jbasila/gree-gmv-esp32/docs/02-bus-discovery.md

# 02 — Bus discovery procedure

## Step 0: squeeze the existing gateway (no hardware needed)

1. Get the gateway IP: it toggles on the LCD every minute, or look at the router's DHCP table.
2. From a laptop on the same LAN:
   ```
   nc <gateway-ip> 10102
   ls2
   line
   ```
   `ls2` should list units like `L6.001 ON 024C 022.7 Low Cool OK - 0` (one line per IDU).
   If that works, add the CoolMasterNet integration in Home Assistant (host = gateway IP,
   port 10102). You now have HA control today, and a scripted way to poke the system while
   sniffing in phase 1.
3. Photograph: gateway sticker (model, S/N), gateway terminal block, and the ODU/IDU terminal
   block it is wired to. Note the terminal labels (G1/G2, D1/D2, H1/H2).

## Step 1: confirm it is CAN with a multimeter (power off nothing)

With the system running, measure each bus wire to the ODU chassis/earth:

| Reading | Meaning |
|---|---|
| both wires ~2.5 V DC, small jitter | CAN (CAN_H / CAN_L idle recessive). Expected. |
| one wire ~0 V, other 12–30 V DC with ripple | power-carrier (H1/H2 style). Different plan. |
| both ~0 V, or ~5 V on one | RS-485-ish or dead line. |

Then measure resistance across the pair with the system **powered off**: ~60 Ω means two
120 Ω terminators, i.e. textbook CAN.

## Step 2: measure the bit rate

Cheapest reliable way: a USB logic analyser (any 24 MHz Saleae clone, ~$10) + PulseView.
Probe CAN_H to GND, set the CAN decoder, read the shortest pulse width. 1/width = bit rate.
Try the ESPHome sniffer below at that rate.

Without a logic analyser: flash `esphome/sniffer.yaml` in listen-only mode and iterate the
`bit_rate` through 20/25/50/100/125 kbps. The correct rate is the one where frames decode and
the TWAI error counters stay at zero. Listen-only never sends ACKs, so a wrong guess cannot
disturb the VRF.

## Hardware shopping list

- ESP32 dev board. Any classic ESP32-WROOM-32 or ESP32-S3; all have TWAI (CAN) built in.
  Classic ESP32 rev < 2 cannot do below 25 kbps; S3/C3/C6 can. Prefer S3 to be safe.
- CAN transceiver breakout, **3.3 V logic**: SN65HVD230 (common, cheap) or TJA1051T/3.
  Do NOT use a 5 V MCP2551/TJA1050 without level shifting.
- Do not add a 120 Ω terminator; the bus is already terminated by Gree.
- Optional: USB logic analyser for PulseView.

## Wiring

```
ESP32 GPIO (tx_pin)  ->  transceiver CTX / D
ESP32 GPIO (rx_pin)  ->  transceiver CRX / R
ESP32 3V3            ->  transceiver VCC
ESP32 GND            ->  transceiver GND
transceiver CANH     ->  G1 (or D1)   (CAN is non-polar per Gree: if nothing decodes, swap)
transceiver CANL     ->  G2 (or D2)
```
Tap the bus in parallel at the same terminals the gateway uses. Keep stubs short.

## Transmit failure diagnosis (2026-10-17)

Symptom: listen-only RX perfect; first transmit → 31 bus errors, error-passive, bus-off, recovery.
Driver reported the frame as sent; the bus never saw it.

Diagnostic firmware `esphome/tx-loop-test.yaml` (raw GPIO: pull CTX low 30 µs, sample CRX):

| Condition | RX low while idle | RX low while TX low |
|---|---|---|
| on the Gree bus | 0–26 / 50 (bus traffic) | 3–9 / 10 (= background only) |
| disconnected from bus | 0 / 50 | 10 / 10 |

→ SN65HVD230 and wiring OK; the Gree bus cannot be pulled dominant by a 3.3 V transceiver
without a shared ground (two signal wires only, ESP32 powered from a laptop). Rs pin = 70 mV (ok),
CTX continuity ok, VCC 3.31 V. DMM on the live bus: CANH ≈ 2.4 V, CANL 0.7–1.4 V relative to
ESP32 GND, i.e. not a 2.5 V-centred bus from our board's point of view.

### Follow-up (2026-10-17 morning)

- Shared ground (ESP32 GND → gateway 12 V negative) changed nothing: loop test still 3–9/10 on-bus.
- Polarity note: when the two bus wires are swapped the receiver goes fully deaf (idle 0/50). Correct
  polarity = whichever gives ~15–35/50 idle on `tx-loop-test.yaml`.
- `tx-hold-test.yaml`: CTX held low for 6 s. RX pin sampled during the hold: 41–100/200 low, i.e. only the
  normal Gree traffic; our dominant never registers, not even at our own receiver.
- Working theory at this point was "a 3.3 V SN65HVD230 cannot move this bus". **Wrong, see below.**

### Oscilloscope session (2026-10-17 evening): the modules are fakes, not the bus

Scope (FNIRSI 1013D, 1X probes, ground on gateway GND) on CANH/CANL at the gateway terminals:

| | idle | Gree dominant |
|---|---|---|
| CANH | ~2.0 V | ~3.8 V |
| CANL | ~2.0 V | ~0.4 V |

Ordinary CAN physical layer, a bit low in common mode, a hefty ~3.4 V dominant swing. With CTX held
low continuously (`tx-hold-forever.yaml`) the picture was **identical** to the ESP32 unpowered: our
driver had zero effect on the bus. Wiring module-pin → bus terminal measured < 1 Ω.

Bench tests off the bus, resistor across CANH–CANL, a second (identical) module swapped in:

| test | load | result |
|---|---|---|
| hold (CTX low continuously) | 100 Ω, 100 kΩ | CANH = CANL = 1.5 V, CRX high, `rx low 0/200`: **no drive at all** |
| 30 µs pulses (`tx-loop-test.yaml`) | 100 kΩ | `10/10`: drives |
| 30 µs pulses | 100 Ω | `0/10`: cannot reach 0.9 V differential |

Module checks: VCC 3.3 V (scope: flat, 250 mV regulator ripple), CTX 3 mV at the chip, Rs (pin 8)
73 mV = normal mode, R1 = 10 kΩ on Rs, R2 (terminator) unpopulated.

**Diagnosis.** Hold vs pulse → the chip has a TXD dominant timeout (genuine SN65HVD230 has none;
TJA1050/MCP2551-class parts do). Pulses into 100 kΩ but not 100 Ω → the driver has almost no current
capability. Both point to a **5 V transceiver die sold as SN65HVD230 and run at 3.3 V**: receiver
works, driver starved. The AliExpress listing (item 1005005334841319) has a May 2026 review saying
exactly that: "All these sn65hvd230 are fakes resp. 5v types that do not work with 3.3v".

**The Gree bus does not need a 5 V transceiver; it needs a genuine one.** The TJA1051T/3 on order
(3.3 V logic, 5 V bus side) is the right part.

**Traps for next time**
- `tx-hold-forever.yaml` cannot pass on any transceiver with a dominant timeout (TJA1051 has one,
  ~1–4 ms). Use `tx-loop-test.yaml` (30 µs pulses) for bench tests.
- Read scope levels from a frozen Single capture / photo, not min/max by eye: the first verbal numbers
  were ringing peaks and produced a bogus "biased bus" theory for an hour.

**Acceptance test for any new transceiver, before it touches the bus:** 100 Ω across CANH–CANL,
`esphome-dev run tx-loop-test.yaml`, expect `rx low while tx driven low: 10/10`.

## 2026-10-26: TJA1051T/3 works

AliExpress clone of the Adafruit CAN Pal (chip marked NXP A1051/3). Vcc → 3V3 (on-board charge pump),
SLNT unconnected (corrected 2026-10-27: it was never wired), termination switch OFF. Bench (100 Ω): `10/10`. On the bus: `10/10`, idle 16–30/50.
First write from HA: `write 0x1CBFD1F3 off=0 len=2 val=E6` (Bedroom 3 → 23.0 °C), echoed in 459 ms,
no bus-off. Power, fan, swing and mode followed, all echoed within 0.8 s. The write path needed no
sequencing beyond what the gateway does.
