jbasila/gree-gmv-esp32/enclosure/vrf-box-base.stl

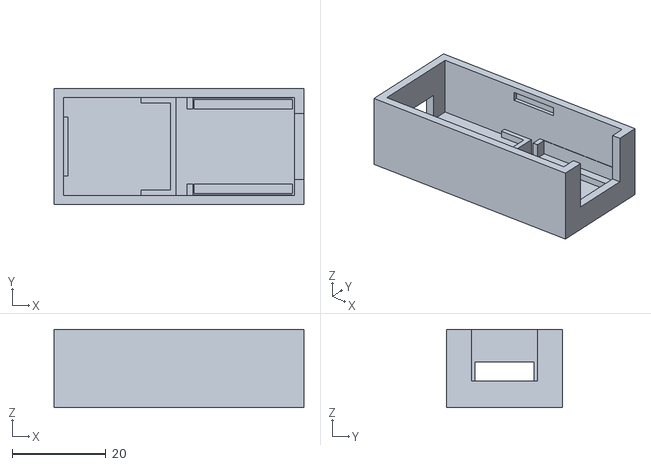
[picture p1: CAD file, 2026-10-29]
enclosure/vrf-box-base.stl
53.3 x 24.8 x 16.7
