jbasila/gree-gmv-esp32/enclosure/vrf-box-lid.stl

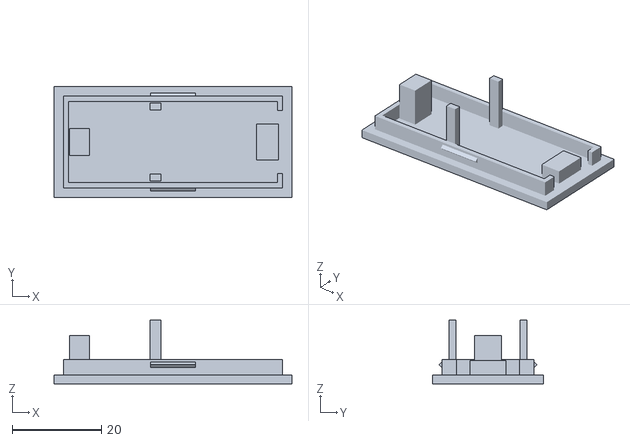
[picture p2: CAD file, 2026-10-29]
enclosure/vrf-box-lid.stl
53.3 x 24.8 x 14.3
