jbasila/gree-gmv-esp32/(commit log)

2026-10-17 Bus discovery, protocol decode, sniffer and diagnostics
    - Gree GMV5 VRF bus identified as CAN 20 kbps (via CoolAutomation gateway 'line' output)
    - ESPHome listen-only sniffer, capture/reassembly/diff tools
    - Protocol: node addressing, segmented transport, field map for power/mode/fan/swing/setpoint/room temp
    - Transmit diagnostics: SN65HVD230 cannot drive this bus; TJA1051T/3 ordered
    - Research notes, gateway findings, handoff
2026-10-17 ESPHome external component gree_gmv: hub + climate platform
    Reassembles the segmented CAN messages per node and exposes one climate
    entity per indoor unit (power, mode, fan, swing, setpoint, room temp).
    Verified read-only against the live bus; writes await a transceiver that
    can drive it.
2026-10-17 Bundle esp32_can override so stable ESPHome 2026.9 builds 20 kbps on classic ESP32; vector send_data for API compat
2026-10-17 esp32_can override: bus-off recovery so a failed transmit no longer kills receive
2026-10-17 Handoff: current state, arrival checklist, code map
2026-10-17 Scope session: bus is plain CAN, both HVD230 modules are fakes; pulse test is the valid bench check
    - docs/02-bus-discovery.md: scope levels, bench tests (hold vs pulse, 100 Ω vs 100 kΩ),
    dominant-timeout trap, acceptance test for the TJA1051T/3
    - docs/HANDOFF.md: write-side blocker rewritten, arrival checklist uses tx-loop-test.yaml
    - esphome/tx-hold-forever.yaml: continuous-hold diagnostic, with a warning about why it fails
2026-10-17 Handoff: paused until the TJA1051T/3 arrives; arrival checklist, 5 V shortcut, backup-order note
2026-10-18 Handoff: Adafruit links, CAN Pal VIO pin and termination switch
2026-10-18 Handoff: Waveshare SN65HVD230 board ordered direct, TJA clone is the backup
2026-10-26 Write side works: TJA1051T/3 clone verified on the bus
    Setpoint, power, fan, swing and mode written from HA to Bedroom 3 (0xD180),
    each echoed by the unit within 0.8 s, no bus-off. README status, bus
    discovery log and handoff updated; handoff drops the nonexistent VIO pin.
2026-10-26 esp32_can override: 20 kbps and bus-off recovery land in 2026.11, not 2026.10
    Checked against the 2026.10.0 source: classic ESP32 has no 20KBPS and there
    is no bus-off recovery. Both are on dev. Keep the override until 2026.11.0.
2026-10-27 Handoff: XIAO ESP32-C3 box plan, no GND wire needed, termination check before removing gateway
2026-10-27 Move vrf to the ESP32-C3 SuperMini: TX GPIO4, RX GPIO3, WiFi 8.5 dB, keep esp32_can override; POC dismantled
2026-10-27 Handoff: C3 SuperMini reads and writes on the bus (24 °C echo 308 ms), GND-CANL 1.3-2.0 V, SLNT never wired
2026-10-29 Build guide with diagrams and enclosure renders, snap-fit enclosure, MIT licence
    docs/TUTORIAL.md: parts, transceiver bench test, wiring, flashing, unit discovery, Home Assistant,
    enclosure, troubleshooting, protocol summary. enclosure/vrf_box.py: 5 mm board gap, snap lid,
    hold-down posts, CAN Pal corner stops (print 3 fits; corner stops pending print 4).
    README: C3 pins (GPIO4/GPIO3), link to the guide.
